sa7bnb/Rakel-Detektor-v1.0/BOM_380–385MHz-LC-Filter-v1.0_2026-02-01.csv

ID | Name | Designator | Footprint | Quantity | Manufacturer Part | Manufacturer | Supplier | Supplier Part | Price
1 | 2.2pF | C1,C2 | C0603 | 2 | GRM1885C1H2R2CA01D | muRata(村田) | LCSC | C162218 | 0.009
2 | 1pF | C3,C4 | C0603 | 2 | GRM1885C1H1R0CA01D | muRata(村田) | LCSC | C162206 | 0.01
3 | 8.2pF | C5,C6,C7 | C0603 | 3 | CL10C8R2CB8NNNC | SAMSUNG(三星) | LCSC | C318673 | 0.007
4 | 3pF~10pF | C8,C9,C10 | CAP-ADJ-SMD_L4.5-W4.2-L | 3 | TZB4Z100AB10R01 | muRata(村田) | LCSC | C19355075 | 1.096
5 | 15nH | L1,L2,L3 | IND-SMD_L1.0-W0.6 | 3 | LQW15AN15NJ00D | muRata(村田) | LCSC | C94079 | 0.037
